conorhealy898/Final-Year-Project/README.md

# Final-Year-Project
Repository for "Active Stabilisation of Motorcycle Roll Dynamics at Low Speeds" final year project.

The files created as part of this project have been uploaded to various online repositories. 
The project report, poster, Arduino code, MATLAB code and Simulink diagrams are available on GitHub at:
https://github.com/conorhealy898/Final-Year-Project

The project video is available on YouTube at:
https://www.youtube.com/watch?v=fFrGl4Du1MM&t=22s

A playlist of Motorcycle Test videos is available on YouTube at:
https://www.youtube.com/watch?v=fm4P5YH1AP8&list=PLI1TINkoYmrWGHYhqJaogXKygd5izlUs6

The SolidWorks and STL files for the motorcycle and IMU test rig are available on GrabCAD at:
https://grabcad.com/library/self-balancing-motorcycle-stl-and-solidworks-files-1
