conorhealy898/Final-Year-Project/EE4050 BE Project Poster (Conor Healy 116334906).pdf

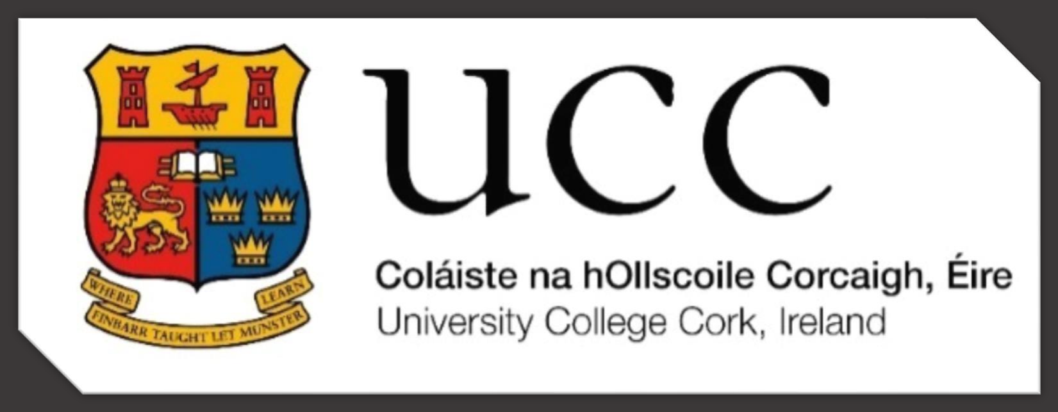
[picture p38: figure]

# Active Stabilisation of Motorcycle Roll Dynamics at Low Speeds

## Student: Conor Healy (116334906) Supervisor: Dr. Gordon Lightbody

## Mechanical Design and Manufacture

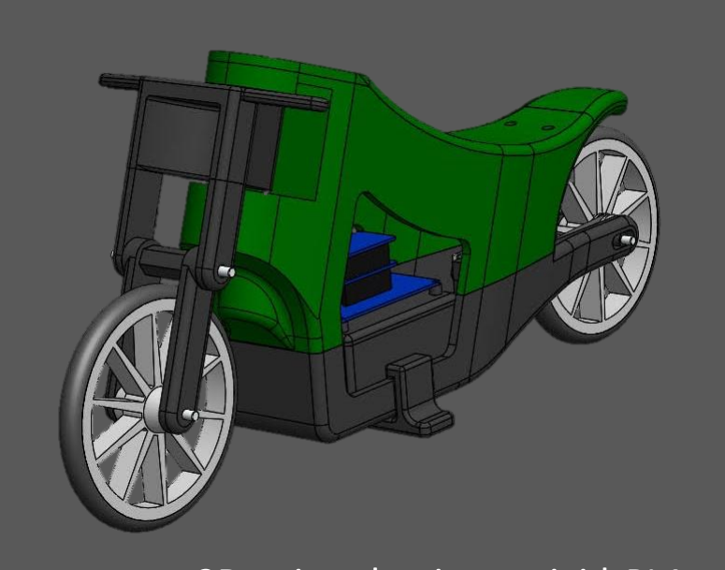
[picture p39: figure]
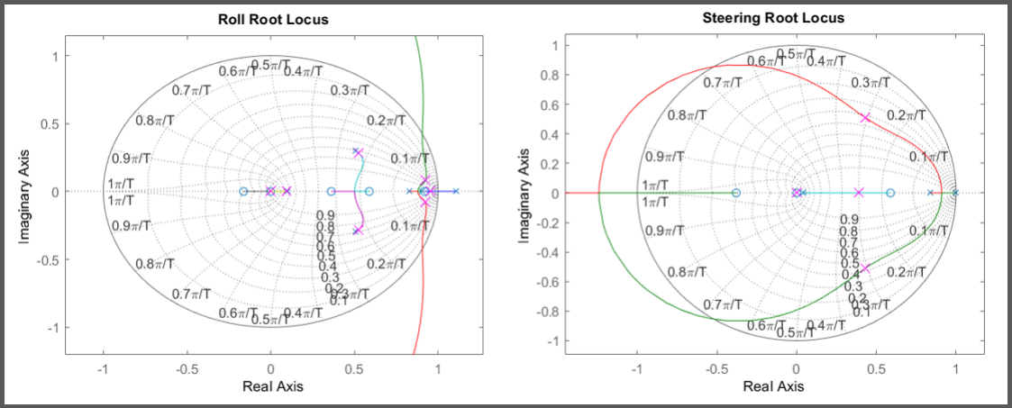
[picture p40: figure]

## Motorcycle Control

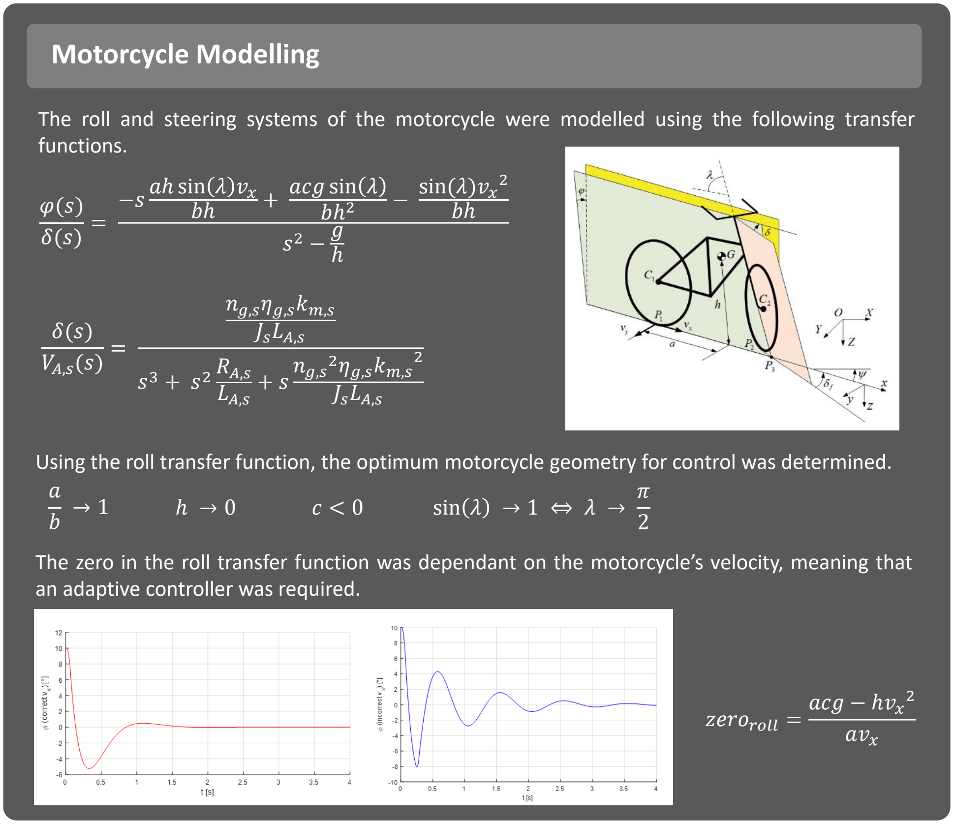
[picture p41: figure]
Motorcycle Modelling; functions.; aℎ sin λ vx; acg sin λ bℎ; sin(λ)vx; ng,sηg,skm,s; JsLA,s; 2ηg,skm,s; sin λ → 1 ⇔ λ →; an adaptive controller was required.; zeroroll =; acg − ℎvx; avx

## Motorcycle Simulation

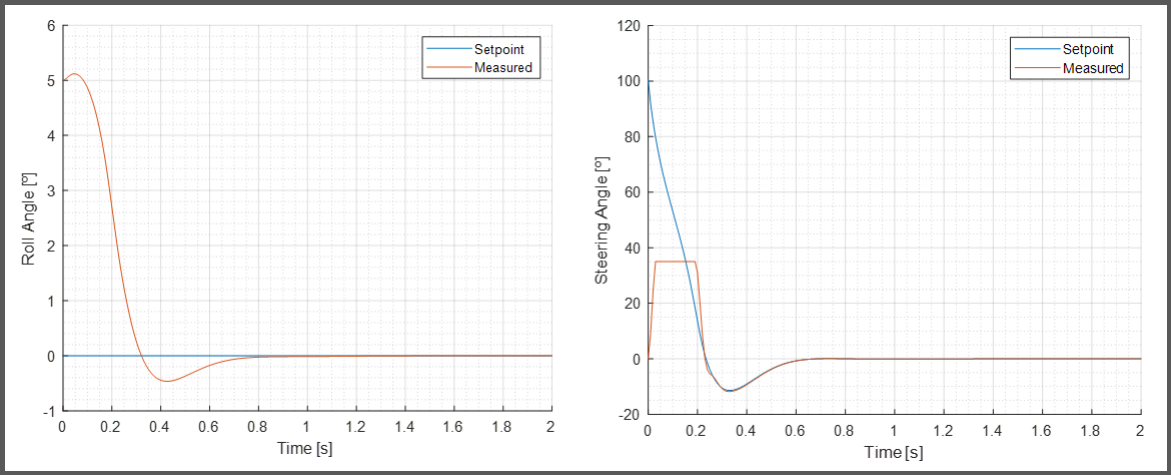
[picture p42: figure]

## Conclusions and Future Work

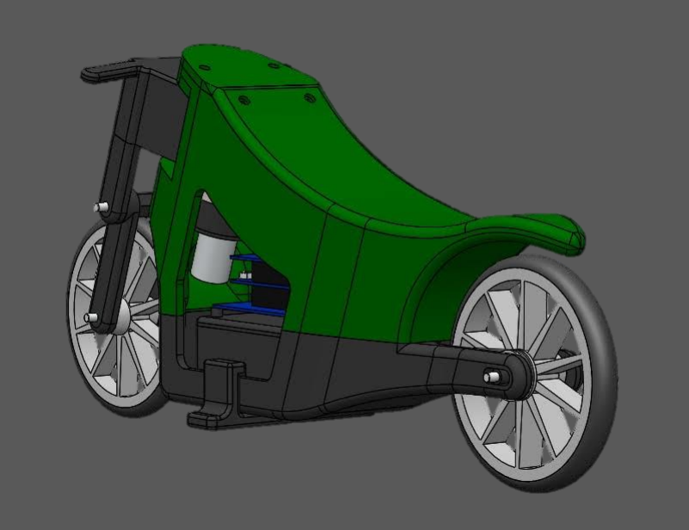
[picture p43: figure]
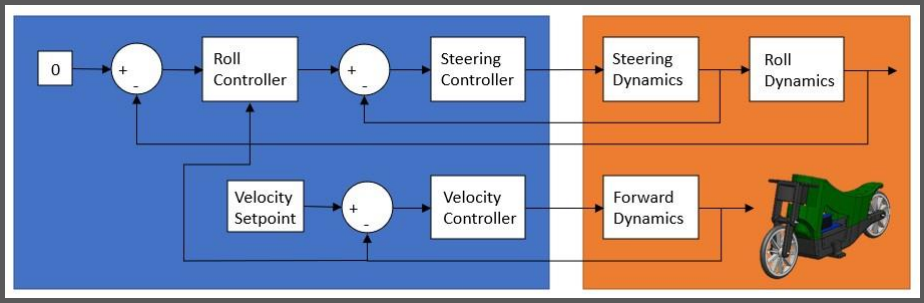
[picture p44: figure]

Cascaded phase lead control of steering and roll systems. Proportional control of drive system.
Arduino MKR microcontroller, motor carrier and IMU used.

Poles and zeros were placed on root locus plots to achieve desired performance The root locus allows the designer to check the system’s stability. Here both systems had 0.707 damping. The natural frequencies of the roll and steering systems were 12 rad s

-1 and 75 rad s

-1
respectively.

Transient plots were used to test controller performance.

The SolidWorks model was designed for optimum controllability and ease of 3D printing.

Most parts were 3D printed using a rigid PLA material, however the tires were printed from a flexible TPU to increase traction. Water soluble support materials enabled fast support removal after printing. Metal parts were used where 3D printing was not sufficient.

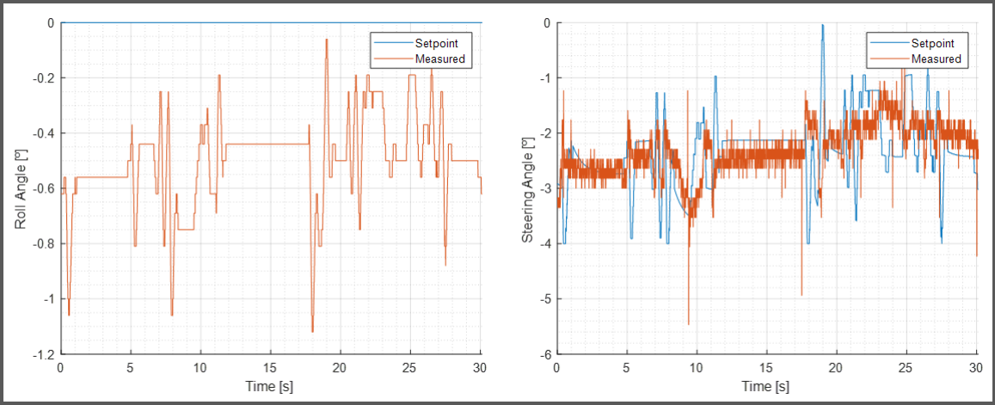
[picture p45: figure]

## Acknowledgements

The Motorcycle was tested while balancing at zero-velocity. The roll plot shows a steady state error which was expected from a Type 0 system with a phase lead controller. Backlash in the steering gearbox resulted in non-optimal setpoint tracking.

The author would like to thank Dr. Gordon Lightbody for his help, guidance and insight throughout the project. The help received from James Griffiths and Hilary Mansfield while ordering components was highly valuable. Michael O'Shea and Tim Power were extremely helpful mounting a sprocket to the steering motor and manufacturing the motorcycle's axles. Special thanks to Michael O'Shea for his assistance with the toothed belt drivetrain. Finally, the author is particularly grateful for the family support received while undertaking this project.

This project was successful in achieving balance control of a stationary motorcycle. The author gained significant insights into systems engineering and the model based design approach and overall the project was a very positive experience.
Mechanical modelling, design for control and manufacture were the main focus of this project. While the author was satisfied with these areas, there is scope to improve the control algorithms used for stabilisation. Potential areas of research include, designing a non-linear state-space controller, further study on stabilisation while moving, improved disturbance rejection and designing a control algorithm that will function when there is a person on the motorcycle.

## Introduction

The main goal of this project was to realise a steering controlled stabilisation system for a motorcycle with the aim of increasing safety at low speeds.
Safer motorcycles would allow drivers who commute alone to travel to work by motorcycle instead of by car, whilst still ensuring their safety. This change would help solve problems with traffic flow and parking shortages.

The roll and steering systems of the motorcycle were modelled using the following transfer

Using the roll transfer function, the optimum motorcycle geometry for control was determined.

The zero in the roll transfer function was dependant on the motorcycle’s velocity, meaning that
