conorhealy898/Final-Year-Project/FYP_MATLAB/Motorcycle_Test_10_1.txt

1  0.00  0.75  -0.75     8.82  3.17  5.65     0.00  0.00  0.00     1.23  2.44      0.00  0.00
2  0.00  0.75  -0.75     8.65  3.00  5.65     0.00  0.00  0.00     1.25  2.44      0.00  0.00
3  0.00  0.75  -0.75     8.48  4.41  4.07     0.00  0.00  0.00     0.93  2.11      0.00  0.00
4  0.00  0.81  -0.81     9.05  6.17  2.88     0.00  0.00  0.00     0.68  1.89      0.00  0.00
5  0.00  0.81  -0.81     8.88  8.11  0.77     0.00  0.00  0.00     0.23  1.44      0.00  0.00
6  0.00  0.94  -0.94     10.18  9.35  0.84     0.00  0.00  0.00     0.25  1.44      0.00  0.00
7  0.00  1.12  -1.12     12.20  9.87  2.32     0.00  0.00  0.00     0.57  1.78      0.00  0.00
8  0.00  1.25  -1.25     13.44  10.23  3.21     0.00  0.00  0.00     0.78  1.89      0.00  0.00
9  0.00  1.31  -1.31     13.92  10.93  2.99     0.00  0.00  0.00     0.74  1.89      0.00  0.00
10  0.00  1.37  -1.37     14.40  11.11  3.29     0.00  0.00  0.00     0.81  2.00      0.00  0.00
11  0.00  1.44  -1.44     14.87  11.64  3.23     0.00  0.00  0.00     0.81  2.00      0.00  0.00
12  0.00  1.44  -1.44     14.60  11.46  3.14     0.00  0.00  0.00     0.80  2.00      0.00  0.00
13  0.00  1.50  -1.50     15.07  11.81  3.26     0.00  0.00  0.00     0.84  2.00      0.00  0.00
14  0.00  1.50  -1.50     14.80  11.99  2.81     0.00  0.00  0.00     0.75  1.89      0.00  0.00
15  0.00  1.50  -1.50     14.54  11.81  2.73     0.00  0.00  0.00     0.74  1.89      0.00  0.00
16  0.00  1.50  -1.50     14.28  11.81  2.47     0.00  0.00  0.00     0.70  1.89      0.00  0.00
17  0.00  1.50  -1.50     14.04  11.99  2.05     0.00  0.00  0.00     0.61  1.78      0.00  0.00
18  0.00  1.50  -1.50     13.80  11.64  2.16     0.00  0.00  0.00     0.64  1.78      0.00  0.00
19  0.00  1.50  -1.50     13.57  11.81  1.75     0.00  0.00  0.00     0.56  1.78      0.00  0.00
20  0.00  1.44  -1.44     12.61  11.64  0.97     0.00  0.00  0.00     0.40  1.55      0.00  0.00
21  0.00  1.44  -1.44     12.40  11.99  0.41     0.00  0.00  0.00     0.28  1.44      0.00  0.00
22  0.00  1.44  -1.44     12.20  11.99  0.21     0.00  0.00  0.00     0.23  1.44      0.00  0.00
23  0.00  1.44  -1.44     12.01  11.81  0.20     0.00  0.00  0.00     0.23  1.44      0.00  0.00
24  0.00  1.37  -1.37     11.09  11.99  -0.90     0.00  0.00  0.00     -0.01  0.00      0.00  0.00
25  0.00  1.37  -1.37     10.92  11.64  -0.71     0.00  0.00  0.00     0.03  0.00      0.00  0.00
26  0.00  1.37  -1.37     10.76  11.64  -0.87     0.00  0.00  0.00     -0.01  0.00      0.00  0.00
27  0.00  1.37  -1.37     10.61  11.46  -0.86     0.00  0.00  0.00     -0.01  0.00      0.00  0.00
28  0.00  1.31  -1.31     9.72  11.46  -1.74     0.00  0.00  0.00     -0.21  -1.33      0.00  0.00
29  0.00  1.25  -1.25     8.85  11.28  -2.43     0.00  0.00  0.00     -0.36  -1.55      0.00  0.00
30  0.00  1.25  -1.25     8.74  9.87  -1.14     0.00  0.00  0.00     -0.09  0.00      0.00  0.00
31  0.00  1.19  -1.19     7.89  9.52  -1.63     0.00  0.00  0.00     -0.20  -1.33      0.00  0.00
32  0.00  1.06  -1.06     6.32  9.17  -2.84     0.00  0.00  0.00     -0.47  -1.66      0.00  0.00
33  0.00  0.88  -0.88     4.06  8.29  -4.23     0.00  0.00  0.00     -0.78  -2.00      0.00  0.00
34  0.00  0.81  -0.81     3.31  6.52  -3.22     0.00  0.00  0.00     -0.58  -1.78      0.00  0.00
35  0.00  0.69  -0.69     1.83  5.47  -3.63     0.00  0.00  0.00     -0.68  -1.89      0.00  0.00
36  0.00  0.50  -0.50     -0.35  4.23  -4.58     0.00  0.00  0.00     -0.90  -2.11      0.00  0.00
37  0.00  0.37  -0.37     -1.75  1.76  -3.51     0.00  0.00  0.00     -0.68  -1.89      0.00  0.00
38  0.00  0.06  -0.06     -5.33  -0.53  -4.80     0.00  0.00  0.00     -0.97  -2.11      0.00  0.00
39  0.00  0.00  0.00     -5.90  -2.64  -3.25     0.00  0.00  0.00     -0.65  -1.78      0.00  0.00
40  0.00  -0.19  0.19     -7.93  -4.94  -2.99     0.00  0.00  0.00     -0.61  -1.78      0.00  0.00
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
