conorhealy898/Final-Year-Project/FYP_MATLAB/Motorcycle_Test_11_1.txt

1  0.00  0.25  -0.25     5.33  -2.47  7.80     0.00  0.00  0.00     2.74  3.66      0.00  0.00
2  0.00  0.31  -0.31     6.12  -1.06  7.18     0.00  0.00  0.00     2.78  3.77      0.00  0.00
3  0.00  0.31  -0.31     5.55  3.00  2.55     0.00  0.00  0.00     1.28  2.22      0.00  0.00
4  0.00  0.31  -0.31     5.08  8.46  -3.39     0.00  0.00  0.00     -0.88  -1.78      0.00  0.00
5  0.00  0.56  -0.56     10.03  11.99  -1.96     0.00  0.00  0.00     -0.61  -1.55      0.00  0.00
6  0.00  1.00  -1.00     18.51  13.22  5.28     0.00  0.00  0.00     1.84  2.77      0.00  0.00
7  0.00  2.06  -2.06     38.00  13.93  24.07     0.00  0.00  0.00     8.62  9.55      0.00  0.00
8  0.00  2.31  -2.31     38.00  16.75  21.25     0.00  0.00  0.00     8.34  9.32      0.00  0.00
9  0.00  2.19  -2.19     32.43  22.75  9.68     0.00  0.00  0.00     4.62  5.55      0.00  0.00
10  0.00  1.87  -1.87     23.67  29.97  -6.31     0.00  0.00  0.00     -1.17  -2.11      0.00  0.00
11  0.00  1.75  -1.75     19.98  37.03  -17.05     0.00  0.00  0.00     -5.57  -6.55      0.00  0.00
12  0.00  3.00  -3.00     38.00  37.91  0.09     0.00  0.00  0.00     -0.27  -1.22      0.00  0.00
13  0.00  4.00  -4.00     38.00  35.44  2.56     0.00  0.00  0.00     0.72  1.66      0.00  0.00
14  0.00  4.75  -4.75     38.00  32.80  5.20     0.00  0.00  0.00     1.81  2.77      0.00  0.00
15  0.00  4.87  -4.87     38.00  32.80  5.20     0.00  0.00  0.00     1.98  2.89      0.00  0.00
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
38  0.00  -7.62  7.62     10.59  -12.17  22.76     0.00  0.00  0.00     8.64  9.55      0.00  0.00
39  0.00  -5.50  5.50     38.00  -5.64  43.64     0.00  0.00  0.00     11.10  12.10      0.00  0.00
40  0.00  -4.94  4.94     32.99  4.06  28.94     0.00  0.00  0.00     9.04  9.99      0.00  0.00
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
