conorhealy898/Final-Year-Project/FYP_MATLAB/Motorcycle_Test_12_1.txt

1  0.00  0.88  -0.88     18.66  -0.18  18.84     0.00  0.00  0.00     6.62  7.55      0.00  0.00
2  0.00  0.88  -0.88     16.77  1.23  15.53     0.00  0.00  0.00     6.07  6.99      0.00  0.00
3  0.00  0.88  -0.88     15.22  8.82  6.41     0.00  0.00  0.00     3.12  4.11      0.00  0.00
4  0.00  0.88  -0.88     13.96  18.34  -4.37     0.00  0.00  0.00     -0.81  -1.78      0.00  0.00
5  0.00  1.25  -1.25     20.94  25.92  -4.98     0.00  0.00  0.00     -1.45  -2.44      0.00  0.00
6  0.00  1.81  -1.81     31.29  27.51  3.79     0.00  0.00  0.00     1.35  2.33      0.00  0.00
7  0.00  3.00  -3.00     38.00  26.98  11.02     0.00  0.00  0.00     4.01  5.00      0.00  0.00
8  0.00  3.31  -3.31     38.00  28.74  9.26     0.00  0.00  0.00     3.69  4.66      0.00  0.00
9  0.00  3.31  -3.31     36.90  31.03  5.87     0.00  0.00  0.00     2.62  3.55      0.00  0.00
10  0.00  2.69  -2.69     22.67  34.03  -11.36     0.00  0.00  0.00     -3.46  -4.44      0.00  0.00
11  0.00  2.69  -2.69     23.30  35.97  -12.67     0.00  0.00  0.00     -4.50  -5.44      0.00  0.00
12  0.00  3.00  -3.00     30.47  32.97  -2.50     0.00  0.00  0.00     -1.32  -2.22      0.00  0.00
13  0.00  3.44  -3.44     38.00  28.74  9.26     0.00  0.00  0.00     2.91  3.88      0.00  0.00
14  0.00  3.75  -3.75     38.00  25.57  12.43     0.00  0.00  0.00     4.46  5.44      0.00  0.00
15  0.00  3.25  -3.25     27.02  26.80  0.22     0.00  0.00  0.00     0.54  1.44      0.00  0.00
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
39  0.00  -7.37  7.38     -30.81  -30.33  -0.48     0.00  0.00  0.00     -0.00  0.00      0.00  0.00
40  0.00  -7.12  7.12     -33.04  -24.86  -8.18     0.00  -0.01  0.01     -2.79  -3.77      0.19  1.55
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
