conorhealy898/Final-Year-Project/FYP_MATLAB/Motorcycle_Test_14_1.txt

1  0.00  -0.94  0.94     -4.00  -0.71  -3.29     0.40  0.00  0.00     -0.47  -1.44      0.00  0.00
2  0.00  -0.81  0.81     -3.42  -1.06  -2.37     0.40  0.00  0.00     -0.38  -1.33      0.00  0.00
3  0.00  -0.62  0.62     -2.56  -1.06  -1.50     0.40  0.00  0.00     -0.29  -1.22      0.00  0.00
4  0.00  -0.56  0.56     -2.27  -1.06  -1.21     0.40  0.00  0.00     -0.27  -1.22      0.00  0.00
5  0.00  -0.56  0.56     -2.28  -1.06  -1.22     0.40  0.00  0.00     -0.28  -1.22      0.00  0.00
6  0.00  -0.69  0.69     -2.87  -0.88  -1.99     0.40  0.00  0.00     -0.41  -1.33      0.00  0.00
7  0.00  -0.81  0.81     -3.46  -1.06  -2.40     0.40  0.00  0.00     -0.49  -1.44      0.00  0.00
8  0.00  -0.88  0.88     -3.76  -1.06  -2.70     0.40  0.00  0.00     -0.57  -1.55      0.00  0.00
9  0.00  -1.00  1.00     -4.00  -0.88  -3.12     0.40  0.00  0.00     -0.66  -1.55      0.00  0.00
10  0.00  -1.19  1.19     -4.00  -1.06  -2.94     0.40  0.00  0.00     -0.68  -1.66      0.00  0.00
11  0.00  -1.25  1.25     -4.00  -1.06  -2.94     0.40  0.00  0.00     -0.71  -1.66      0.00  0.00
12  0.00  -1.37  1.37     -4.00  -1.06  -2.94     0.40  0.00  0.00     -0.75  -1.66      0.00  0.00
13  0.00  -1.37  1.37     -4.00  -1.06  -2.94     0.40  0.00  0.00     -0.79  -1.78      0.00  0.00
14  0.00  -1.50  1.50     -4.00  -0.88  -3.12     0.40  0.00  0.00     -0.85  -1.78      0.00  0.00
15  0.00  -1.50  1.50     -4.00  -1.06  -2.94     0.40  0.00  0.00     -0.86  -1.78      0.00  0.00
16  0.00  -1.56  1.56     -4.00  -1.06  -2.94     0.40  0.00  0.00     -0.90  -1.89      0.00  0.00
17  0.00  -1.62  1.62     -4.00  -1.06  -2.94     0.40  0.00  0.00     -0.94  -1.89      0.00  0.00
18  0.00  -1.69  1.69     -4.00  -1.41  -2.59     0.40  0.00  0.00     -0.92  -1.89      0.00  0.00
19  0.00  -1.69  1.69     -4.00  -1.23  -2.77     0.40  0.00  0.00     -0.98  -1.89      0.00  0.00
20  0.00  -1.69  1.69     -4.00  -1.23  -2.77     0.40  0.00  0.00     -1.01  -2.00      0.00  0.00
21  0.00  -1.69  1.69     -4.00  -1.59  -2.41     0.40  0.00  0.00     -0.99  -1.89      0.00  0.00
22  0.00  -1.62  1.62     -3.76  -1.23  -2.53     0.40  0.00  0.00     -1.04  -2.00      0.00  0.00
23  0.00  -1.56  1.56     -3.53  -1.59  -1.94     0.40  0.00  0.00     -0.98  -1.89      0.00  0.00
24  0.00  -1.50  1.50     -3.29  -1.59  -1.71     0.40  0.00  0.00     -0.97  -1.89      0.00  0.00
25  0.00  -1.37  1.37     -2.76  -1.59  -1.18     0.40  0.00  0.00     -0.91  -1.89      0.00  0.00
26  0.00  -1.31  1.31     -2.52  -1.76  -0.76     0.40  0.00  0.00     -0.86  -1.78      0.00  0.00
27  0.00  -1.25  1.25     -2.28  -2.12  -0.17     0.40  0.00  0.00     -0.78  -1.78      0.00  0.00
28  0.00  -1.19  1.19     -2.04  -1.76  -0.28     0.40  0.00  0.00     -0.80  -1.78      0.00  0.00
29  0.00  -1.06  1.06     -1.51  -1.94  0.43     0.40  0.00  0.00     -0.69  -1.66      0.00  0.00
30  0.00  -0.94  0.94     -0.98  -2.29  1.32     0.40  0.00  0.00     -0.56  -1.55      0.00  0.00
31  0.00  -0.88  0.88     -0.73  -2.29  1.56     0.40  0.00  0.00     -0.50  -1.44      0.00  0.00
32  0.00  -0.69  0.69     0.10  -2.47  2.56     0.40  0.00  0.00     -0.33  -1.22      0.00  0.00
33  0.00  -0.62  0.62     0.34  -2.47  2.81     0.40  0.00  0.00     -0.26  -1.22      0.00  0.00
34  0.00  -0.56  0.56     0.59  -2.29  2.88     0.40  0.00  0.00     -0.20  -1.11      0.00  0.00
35  0.00  -0.50  0.50     0.83  -2.29  3.13     0.40  0.00  0.00     -0.12  -1.11      0.00  0.00
36  0.00  -0.50  0.50     0.79  -2.29  3.08     0.40  0.00  0.00     -0.09  0.00      0.00  0.00
37  0.00  -0.50  0.50     0.75  -2.29  3.04     0.40  0.00  0.00     -0.05  0.00      0.00  0.00
38  0.00  -0.50  0.50     0.71  -2.29  3.00     0.40  0.00  0.00     -0.01  0.00      0.00  0.00
39  0.00  -0.50  0.50     0.66  -2.29  2.96     0.40  0.00  0.00     0.03  0.00      0.00  0.00
40  0.00  -0.50  0.50     0.62  -2.29  2.91     0.40  0.00  0.00     0.06  0.00      0.00  0.00
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
