conorhealy898/Final-Year-Project/FYP_MATLAB/Motorcycle_Test_14_2.txt

1  0.00  -0.62  0.62     -2.92  -3.17  0.26     0.40  0.00  0.00     0.04  0.00      0.00  0.00
2  0.00  -0.62  0.62     -2.92  -3.17  0.25     0.40  0.00  0.00     0.04  0.00      0.00  0.00
3  0.00  -0.62  0.62     -2.92  -3.17  0.25     0.40  0.00  0.00     0.04  0.00      0.00  0.00
4  0.00  -0.62  0.62     -2.92  -3.35  0.43     0.40  0.00  0.00     0.07  0.00      0.00  0.00
5  0.00  -0.62  0.62     -2.92  -3.35  0.43     0.40  0.00  0.00     0.08  0.00      0.00  0.00
6  0.00  -0.62  0.62     -2.93  -3.17  0.25     0.40  0.00  0.00     0.06  0.00      0.00  0.00
7  0.00  -0.62  0.62     -2.93  -3.35  0.42     0.40  0.00  0.00     0.08  0.00      0.00  0.00
8  0.00  -0.62  0.62     -2.93  -3.35  0.42     0.40  0.00  0.00     0.09  0.00      0.00  0.00
9  0.00  -0.62  0.62     -2.93  -3.17  0.24     0.40  0.00  0.00     0.07  0.00      0.00  0.00
10  0.00  -0.62  0.62     -2.93  -3.17  0.24     0.40  0.00  0.00     0.07  0.00      0.00  0.00
11  0.00  -0.62  0.62     -2.93  -3.17  0.24     0.40  0.00  0.00     0.08  0.00      0.00  0.00
12  0.00  -0.62  0.62     -2.94  -3.35  0.41     0.40  0.00  0.00     0.10  0.00      0.00  0.00
13  0.00  -0.62  0.62     -2.94  -3.17  0.24     0.40  0.00  0.00     0.08  0.00      0.00  0.00
14  0.00  -0.62  0.62     -2.94  -3.17  0.24     0.40  0.00  0.00     0.09  0.00      0.00  0.00
15  0.00  -0.62  0.62     -2.94  -3.35  0.41     0.40  0.00  0.00     0.11  1.11      0.00  0.00
16  0.00  -0.62  0.62     -2.94  -3.17  0.23     0.40  0.00  0.00     0.09  0.00      0.00  0.00
17  0.00  -0.62  0.62     -2.94  -3.00  0.05     0.40  0.00  0.00     0.07  0.00      0.00  0.00
18  0.00  -0.62  0.62     -2.94  -3.35  0.41     0.40  0.00  0.00     0.12  1.11      0.00  0.00
19  0.00  -0.62  0.62     -2.95  -3.17  0.23     0.40  0.00  0.00     0.10  0.00      0.00  0.00
20  0.00  -0.62  0.62     -2.95  -2.64  -0.30     0.40  0.00  0.00     0.03  0.00      0.00  0.00
21  0.00  -0.56  0.56     -2.66  -3.35  0.69     0.40  0.00  0.00     0.17  1.11      0.00  0.00
22  0.00  -0.56  0.56     -2.66  -3.17  0.52     0.40  0.00  0.00     0.15  1.11      0.00  0.00
23  0.00  -0.56  0.56     -2.66  -2.82  0.16     0.40  0.00  0.00     0.10  0.00      0.00  0.00
24  0.00  -0.56  0.56     -2.66  -2.82  0.16     0.40  0.00  0.00     0.11  0.00      0.00  0.00
25  0.00  -0.56  0.56     -2.66  -2.47  -0.19     0.40  0.00  0.00     0.06  0.00      0.00  0.00
26  0.00  -0.56  0.56     -2.66  -2.82  0.16     0.40  0.00  0.00     0.10  0.00      0.00  0.00
27  0.00  -0.56  0.56     -2.66  -2.64  -0.02     0.40  0.00  0.00     0.08  0.00      0.00  0.00
28  0.00  -0.56  0.56     -2.66  -2.64  -0.02     0.40  0.00  0.00     0.08  0.00      0.00  0.00
29  0.00  -0.56  0.56     -2.67  -2.82  0.16     0.40  0.00  0.00     0.10  0.00      0.00  0.00
30  0.00  -0.56  0.56     -2.67  -2.64  -0.02     0.40  0.00  0.00     0.08  0.00      0.00  0.00
31  0.00  -0.56  0.56     -2.67  -2.64  -0.02     0.40  0.00  0.00     0.08  0.00      0.00  0.00
32  0.00  -0.56  0.56     -2.67  -3.00  0.33     0.40  0.00  0.00     0.13  1.11      0.00  0.00
33  0.00  -0.56  0.56     -2.67  -2.82  0.15     0.40  0.00  0.00     0.11  0.00      0.00  0.00
34  0.00  -0.62  0.62     -2.96  -1.94  -1.02     0.40  0.00  0.00     -0.06  0.00      0.00  0.00
35  0.00  -0.62  0.62     -2.96  -1.76  -1.20     0.40  0.00  0.00     -0.10  0.00      0.00  0.00
36  0.00  -0.62  0.62     -2.96  -1.94  -1.03     0.40  0.00  0.00     -0.09  0.00      0.00  0.00
37  0.00  -0.62  0.62     -2.97  -1.94  -1.03     0.40  0.00  0.00     -0.11  0.00      0.00  0.00
38  0.00  -0.62  0.62     -2.97  -1.76  -1.20     0.40  0.00  0.00     -0.14  -1.11      0.00  0.00
39  0.00  -0.69  0.69     -3.26  -1.76  -1.50     0.40  0.00  0.00     -0.20  -1.11      0.00  0.00
40  0.00  -0.69  0.69     -3.26  -1.76  -1.50     0.40  0.00  0.00     -0.22  -1.22      0.00  0.00
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
