conorhealy898/Final-Year-Project/FYP_MATLAB/Motorcycle_Test_7_1.txt

1  0.00  2.69  -2.69     21.50  -4.94  26.44     0.00  0.00  0.00     5.63  5.55      0.00  0.00
2  0.00  2.69  -2.69     21.50  -2.82  24.32     0.00  0.00  0.00     5.27  5.22      0.00  0.00
3  0.00  2.62  -2.62     21.00  2.47  18.54     0.00  0.00  0.00     4.11  4.11      0.00  0.00
4  0.00  2.56  -2.56     20.51  6.52  13.98     0.00  0.00  0.00     3.20  3.11      0.00  0.00
5  0.00  2.56  -2.56     20.51  8.82  11.69     0.00  0.00  0.00     2.76  2.66      0.00  0.00
6  0.00  2.62  -2.62     21.01  9.35  11.67     0.00  0.00  0.00     2.79  2.77      0.00  0.00
7  0.00  2.56  -2.56     20.51  8.99  11.52     0.00  0.00  0.00     2.80  2.77      0.00  0.00
8  0.00  2.44  -2.44     19.51  8.99  10.52     0.00  0.00  0.00     2.62  2.55      0.00  0.00
9  0.00  2.06  -2.06     16.52  9.35  7.17     0.00  0.00  0.00     1.94  1.89      0.00  0.00
10  0.00  1.94  -1.94     15.52  9.52  6.00     0.00  0.00  0.00     1.71  1.66      0.00  0.00
11  0.00  1.87  -1.87     15.02  9.17  5.85     0.00  0.00  0.00     1.70  1.66      0.00  0.00
12  0.00  1.81  -1.81     14.52  9.35  5.18     0.00  0.00  0.00     1.57  1.55      0.00  0.00
13  0.00  1.81  -1.81     14.52  9.17  5.35     0.00  0.00  0.00     1.63  1.55      0.00  0.00
14  0.00  1.75  -1.75     14.02  9.35  4.68     0.00  0.00  0.00     1.50  1.44      0.00  0.00
15  0.00  1.75  -1.75     14.03  9.35  4.68     0.00  0.00  0.00     1.51  1.44      0.00  0.00
16  0.00  1.75  -1.75     14.03  9.17  4.86     0.00  0.00  0.00     1.57  1.55      0.00  0.00
17  0.00  1.75  -1.75     14.03  9.35  4.68     0.00  0.00  0.00     1.54  1.44      0.00  0.00
18  0.00  1.75  -1.75     14.03  9.35  4.68     0.00  0.00  0.00     1.56  1.55      0.00  0.00
19  0.00  1.87  -1.87     15.03  9.17  5.86     0.00  0.00  0.00     1.82  1.78      0.00  0.00
20  0.00  1.94  -1.94     15.53  9.52  6.01     0.00  0.00  0.00     1.87  1.78      0.00  0.00
21  0.00  2.00  -2.00     16.03  9.52  6.51     0.00  0.00  0.00     2.00  1.89      0.00  0.00
22  0.00  2.12  -2.12     17.04  9.35  7.69     0.00  0.00  0.00     2.27  2.22      0.00  0.00
23  0.00  2.19  -2.19     17.54  9.35  8.19     0.00  0.00  0.00     2.40  2.33      0.00  0.00
24  0.00  2.19  -2.19     17.54  9.35  8.19     0.00  0.00  0.00     2.42  2.33      0.00  0.00
25  0.00  2.19  -2.19     17.54  9.87  7.67     0.00  0.00  0.00     2.33  2.33      0.00  0.00
26  0.00  2.19  -2.19     17.54  9.87  7.67     0.00  0.00  0.00     2.36  2.33      0.00  0.00
27  0.00  2.25  -2.25     18.04  10.40  7.64     0.00  0.00  0.00     2.37  2.33      0.00  0.00
28  0.00  2.25  -2.25     18.05  10.93  7.11     0.00  0.00  0.00     2.29  2.22      0.00  0.00
29  0.00  2.25  -2.25     18.05  11.28  6.76     0.00  0.00  0.00     2.23  2.22      0.00  0.00
30  0.00  2.37  -2.37     19.05  11.46  7.59     0.00  0.00  0.00     2.43  2.33      0.00  0.00
31  0.00  2.37  -2.37     19.05  11.99  7.06     0.00  0.00  0.00     2.34  2.33      0.00  0.00
32  0.00  2.44  -2.44     19.55  12.34  7.21     0.00  0.00  0.00     2.39  2.33      0.00  0.00
33  0.00  2.37  -2.37     19.05  13.05  6.01     0.00  0.00  0.00     2.16  2.11      0.00  0.00
34  0.00  2.31  -2.31     18.56  13.58  4.98     0.00  0.00  0.00     1.95  1.89      0.00  0.00
35  0.00  2.06  -2.06     16.56  13.75  2.81     0.00  0.00  0.00     1.50  1.44      0.00  0.00
36  0.00  1.94  -1.94     15.56  13.93  1.63     0.00  0.00  0.00     1.26  1.22      0.00  0.00
37  0.00  1.75  -1.75     14.06  13.58  0.48     0.00  0.00  0.00     1.02  1.00      0.00  0.00
38  0.00  1.50  -1.50     12.06  13.58  -1.51     0.00  0.00  0.00     0.59  0.56      0.00  0.00
39  0.00  1.06  -1.06     8.56  13.58  -5.01     0.00  0.00  0.00     -0.16  -0.11      0.00  0.00
40  0.00  0.81  -0.81     6.56  13.75  -7.19     0.00  0.00  0.00     -0.64  -0.56      0.00  0.00
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
