conorhealy898/Final-Year-Project/FYP_MATLAB/Motorcycle_Test_8_1.txt

1  0.00  0.75  -0.75     17.64  1.06  16.58     0.00  0.00  0.00     3.62  3.55      0.00  0.00
2  0.00  0.75  -0.75     17.29  1.59  15.71     0.00  0.00  0.00     3.49  3.44      0.00  0.00
3  0.00  0.75  -0.75     16.96  4.76  12.20     0.00  0.00  0.00     2.77  2.66      0.00  0.00
4  0.00  0.69  -0.69     15.16  8.99  6.17     0.00  0.00  0.00     1.50  1.44      0.00  0.00
5  0.00  0.75  -0.75     16.35  12.17  4.18     0.00  0.00  0.00     1.08  1.00      0.00  0.00
6  0.00  0.88  -0.88     18.98  13.58  5.40     0.00  0.00  0.00     1.36  1.33      0.00  0.00
7  0.00  1.12  -1.12     24.50  13.93  10.57     0.00  0.00  0.00     2.51  2.44      0.00  0.00
8  0.00  1.37  -1.37     29.92  14.11  15.82     0.00  0.00  0.00     3.69  3.66      0.00  0.00
9  0.00  1.44  -1.44     30.83  14.81  16.02     0.00  0.00  0.00     3.79  3.77      0.00  0.00
10  0.00  1.44  -1.44     30.26  15.52  14.74     0.00  0.00  0.00     3.56  3.55      0.00  0.00
11  0.00  1.37  -1.37     28.23  17.81  10.42     0.00  0.00  0.00     2.67  2.66      0.00  0.00
12  0.00  1.37  -1.37     27.72  20.10  7.61     0.00  0.00  0.00     2.09  2.00      0.00  0.00
13  0.00  1.56  -1.56     31.63  20.98  10.65     0.00  0.00  0.00     2.78  2.77      0.00  0.00
14  0.00  1.69  -1.69     34.00  21.16  12.84     0.00  0.00  0.00     3.29  3.22      0.00  0.00
15  0.00  1.69  -1.69     33.39  21.34  12.06     0.00  0.00  0.00     3.16  3.11      0.00  0.00
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
39  0.00  -6.12  6.12     -38.00  -28.56  -9.44     0.00  0.00  0.00     -2.49  -2.44      0.00  0.00
40  0.00  -6.25  6.25     -38.00  -28.21  -9.79     0.00  0.00  0.00     -2.60  -2.55      0.00  0.00
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
