conorhealy898/Final-Year-Project/FYP_MATLAB/Motorcycle_Test_9_1.txt

1  0.00  -4.00  4.00     -38.00  0.00  -38.00     0.00  0.00  0.00     -8.30  -8.21      0.00  0.00
2  0.00  -3.94  3.94     -36.61  -1.59  -35.02     0.00  0.00  0.00     -7.78  -7.77      0.00  0.00
3  0.00  -3.87  3.87     -35.25  -7.76  -27.50     0.00  0.00  0.00     -6.25  -6.22      0.00  0.00
4  0.00  -3.81  3.81     -33.93  -15.69  -18.24     0.00  0.00  0.00     -4.32  -4.22      0.00  0.00
5  0.00  -3.87  3.87     -34.11  -25.04  -9.07     0.00  0.00  0.00     -2.38  -2.33      0.00  0.00
6  0.00  -4.25  4.25     -37.97  -34.56  -3.41     0.00  0.00  0.00     -1.17  -1.11      0.00  0.00
7  0.00  -5.00  5.00     -38.00  -42.67  4.67     0.00  0.00  0.00     0.58  0.56      0.00  0.00
8  0.00  -6.75  6.75     -38.00  -43.20  5.20     0.00  0.00  0.00     0.71  0.67      0.00  0.00
9  0.00  -7.50  7.50     -38.00  -43.20  5.20     0.00  0.01  -0.01     0.73  0.67      -0.19  -0.11
10  0.00  -8.81  8.81     -38.00  -43.20  5.20     0.00  0.00  -0.00     0.75  0.67      -0.09  0.00
11  0.00  -9.13  9.13     -38.00  -43.20  5.20     0.00  0.00  0.00     0.77  0.67      0.00  0.00
12  0.00  -9.13  9.13     -37.95  -43.20  5.25     0.00  0.00  0.00     0.80  0.78      0.00  0.00
13  0.00  -8.94  8.94     -35.69  -43.20  7.51     0.00  0.00  0.00     1.31  1.22      0.00  0.00
14  0.00  -8.69  8.69     -32.75  -43.20  10.45     0.00  0.00  0.00     1.98  1.89      0.00  0.00
15  0.00  -8.63  8.63     -32.06  -43.20  11.13     0.00  0.00  0.00     2.16  2.11      0.00  0.00
16  0.00  -8.63  8.63     -32.13  -40.91  8.78     0.00  0.00  0.00     1.68  1.66      0.00  0.00
17  0.00  -8.56  8.56     -31.46  -38.09  6.63     0.00  0.00  0.00     1.25  1.22      0.00  0.00
18  0.00  -8.50  8.50     -30.80  -35.26  4.47     0.00  0.00  0.00     0.80  0.78      0.00  0.00
19  0.00  -8.38  8.38     -29.42  -32.27  2.85     0.00  0.00  0.00     0.46  0.44      0.00  0.00
20  0.00  -8.19  8.19     -27.33  -29.97  2.65     0.00  0.00  0.00     0.42  0.33      0.00  0.00
21  0.00  -8.00  8.00     -25.28  -28.74  3.47     0.00  0.00  0.00     0.61  0.56      0.00  0.00
22  0.00  -7.81  7.81     -23.26  -28.39  5.12     0.00  0.00  0.00     0.99  0.89      0.00  0.00
23  0.00  -7.50  7.50     -19.82  -28.39  8.57     0.00  0.00  0.00     1.76  1.66      0.00  0.00
24  0.00  -7.37  7.38     -18.64  -28.04  9.39     0.00  0.00  0.00     1.97  1.89      0.00  0.00
25  0.00  -7.19  7.19     -16.75  -27.68  10.93     0.00  0.00  0.00     2.33  2.33      0.00  0.00
26  0.00  -7.06  7.06     -15.63  -26.45  10.82     0.00  0.00  0.00     2.34  2.33      0.00  0.00
27  0.00  -6.94  6.94     -14.53  -24.16  9.63     0.00  0.00  0.00     2.12  2.11      0.00  0.00
28  0.00  -6.56  6.56     -10.51  -21.86  11.36     0.00  0.00  0.00     2.53  2.44      0.00  0.00
29  0.00  -6.37  6.37     -8.76  -19.57  10.81     0.00  0.00  0.00     2.45  2.44      0.00  0.00
30  0.00  -6.19  6.19     -7.05  -16.57  9.53     0.00  0.00  0.00     2.21  2.11      0.00  0.00
31  0.00  -5.94  5.94     -4.63  -13.93  9.30     0.00  0.00  0.00     2.19  2.11      0.00  0.00
32  0.00  -5.75  5.75     -2.98  -10.23  7.24     0.00  0.00  0.00     1.77  1.66      0.00  0.00
33  0.00  -5.56  5.56     -1.37  -7.05  5.69     0.00  0.00  0.00     1.46  1.44      0.00  0.00
34  0.00  -5.19  5.19     2.43  -3.35  5.78     0.00  0.00  0.00     1.50  1.44      0.00  0.00
35  0.00  -4.94  4.94     4.69  -0.35  5.04     0.00  0.00  0.00     1.35  1.33      0.00  0.00
36  0.00  -4.56  4.56     8.38  0.71  7.67     0.00  0.00  0.00     1.94  1.89      0.00  0.00
37  0.00  -4.37  4.37     9.80  1.76  8.04     0.00  0.00  0.00     2.05  2.00      0.00  0.00
38  0.00  -4.25  4.25     10.46  3.35  7.11     0.00  0.00  0.00     1.87  1.78      0.00  0.00
39  0.00  -4.19  4.19     10.39  4.06  6.33     0.00  0.00  0.00     1.73  1.66      0.00  0.00
40  0.00  -4.12  4.12     10.33  4.94  5.39     0.00  0.00  0.00     1.54  1.44      0.00  0.00
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
